zninjamonkey/3A-UPS-module/README.md

# 3A-UPS-module
made for hack club half life in 1 week. cut me some slack

This is supposed to be a UPS (uninterruptible power supply) module to power portable diy electronics projects.

It was inspired by the adafruit powerboost 1000c, but I wanted usb C connection and to be able to provide higher current to power devices such as a rapsberry pi.

It uses a BQ25306 for battery charging and load sharing, and a TPS61089 to boost the lithium ion battery to a 5V output. both chips are by Texas instruments. 

**kicad render**

<br>
**schematic**

<br>

I have not actually built this yet so I'm not sure if it even works
