zninjamonkey/3A-UPS-module/BOM.md

# Battery UPS board – bill of materials

<!-- Generated by Half Life from project cmuvqrdf302p601o9x2sgkxqi. Edits here are overwritten on the next sync. -->
<!-- Generated: 2026-10-13T04:54:23.885Z -->

> [!NOTE]
> This parts list is mirrored from [Half Life](https://halflife.hackclub.com). Editing it here will not change the platform's copy, and the next sync overwrites this file.

| Week | Tier | Parts funding |
| --- | --- | --- |
| Week 1 | Tier 1 | $30.00 |

| Part | What it's for | Qty | Unit | Total | Vendor |
| --- | --- | --- | --- | --- | --- |
| [TI BQ25306RTER](https://www.lcsc.com/product-detail/C3682611.html?s_z=s_p_BQ25306RTER) | battery charging and load sharing | 1 | $1.08 | $1.08 | [LCSC](https://www.lcsc.com/product-detail/C3682611.html?s_z=s_p_BQ25306RTER) |
| [TI TPS61089RNRR](https://www.lcsc.com/product-detail/C165129.html?s_z=n_q_TPS61089) | Battery Voltage Booster | 1 | $0.72 | $0.72 | [LCSC](https://www.lcsc.com/product-detail/C165129.html?s_z=n_q_TPS61089) |
| [AOS AO3401A](https://www.lcsc.com/product-detail/C15127.html?s_z=n_q_AO3401) | Load Sharing with BQ25306 | 1 | $0.51 | $0.51 | [LCSC](https://www.lcsc.com/product-detail/C15127.html?s_z=n_q_AO3401) |
| [USB4125-GF-A](https://www.lcsc.com/product-detail/C3151650.html?s_z=s_p_x_USB4125-GF-A) | charging the battery/powering the load | 1 | $1.05 | $1.05 | [LCSC](https://www.lcsc.com/product-detail/C3151650.html?s_z=s_p_x_USB4125-GF-A) |
| [XFCN PZ254R-11-02P](https://www.lcsc.com/product-detail/C492410.html?s_z=n_q_t_pin%2520header) | connecting an external battery and a load | 1 | $0.43 | $0.43 | [LCSC](https://www.lcsc.com/product-detail/C492410.html?s_z=n_q_t_pin%2520header) |
| [PCB](https://cart.jlcpcb.com/quote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) | connecting the components | 1 | $1.00 | $1.00 | [JLCPCB](https://cart.jlcpcb.com/quote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) |
| [Other passives](https://lcsc.com) | making it work | 1 | $6.39 | $6.39 | [LCSC](https://lcsc.com) |
| **Parts subtotal** | — | — | — | **$11.18** | — |
| **Tax & shipping** | — | — | — | **$21.35** | — |
| **Total** | — | — | — | **$32.53** | — |

**$2.53 over the tier's funding.** Every tier gives a fixed amount for parts, so this needs cutting back or a higher tier.
