zninjamonkey/3A-UPS-module/bom.csv

Id | Designator | Footprint | Quantity | Designation | Supplier and ref
1 | BT1 | PinHeader_1x02_P2.54mm_Horizontal | 1 | Battery_Cell
2 | C1 | C_1206_3216Metric | 1 | 10μF
3 | C2 | C_1206_3216Metric | 1 | 0.1μ
4 | C3, C4, C7, C8 | C_1206_3216Metric | 4 | 22μF
5 | C5 | C_1206_3216Metric | 1 | 120pF
6 | C6 | C_1206_3216Metric | 1 | 2.2nF
7 | C9, C10 | C_1206_3216Metric | 2 | 2.2µF
8 | C11 | C_1206_3216Metric | 1 | 470pF
9 | C12 | C_1206_3216Metric | 1 | 47 nF
10 | C13, C14 | C_1206_3216Metric | 2 | 10µF
11 | D2 | D_1206_3216Metric | 1 | D
12 | D4 | LED_1206_3216Metric | 1 | LED
13 | J1 | USB_C_Receptacle_GCT_USB4125-xx-x_6P_TopMnt_Horizontal | 1 | USB_C_Receptacle_PowerOnly_6P
14 | J3 | PinHeader_1x02_P2.54mm_Horizontal | 1 | Conn_01x02_Pin
15 | L1 | L_6.3x6.3_H3 | 1 | 2.2μH
16 | L2 | L_6.3x6.3_H3 | 1 | 1µH
17 | Q1 | SOT-23 | 1 | Q_PMOS_GDS
18 | R1, R2 | R_1206_3216Metric | 2 | 5.1k
19 | R3 | R_1206_3216Metric | 1 | 300k
20 | R4 | R_1206_3216Metric | 1 | 330k
21 | R5 | R_1206_3216Metric | 1 | 100k
22 | R6 | R_1206_3216Metric | 1 | 24k
23 | R7 | R_1206_3216Metric | 1 | 127k
24 | R8, R9, R12, R13, R16 | R_1206_3216Metric | 5 | 10k
25 | R10 | R_1206_3216Metric | 1 | 80k (0.5a)
26 | R11 | R_1206_3216Metric | 1 | 1k
27 | R14 | R_1206_3216Metric | 1 | 560k
28 | R15 | R_1206_3216Metric | 1 | 200k
29 | U1 | modified tps61089 | 1 | TPS61089
30 | U2 | IC_BQ25306RTER | 1 | BQ25306RTER
