zninjamonkey/3A-UPS-module/design files/board.kicad_pcb

## KiCad design design files/board.kicad_pcb (2026-10-13)

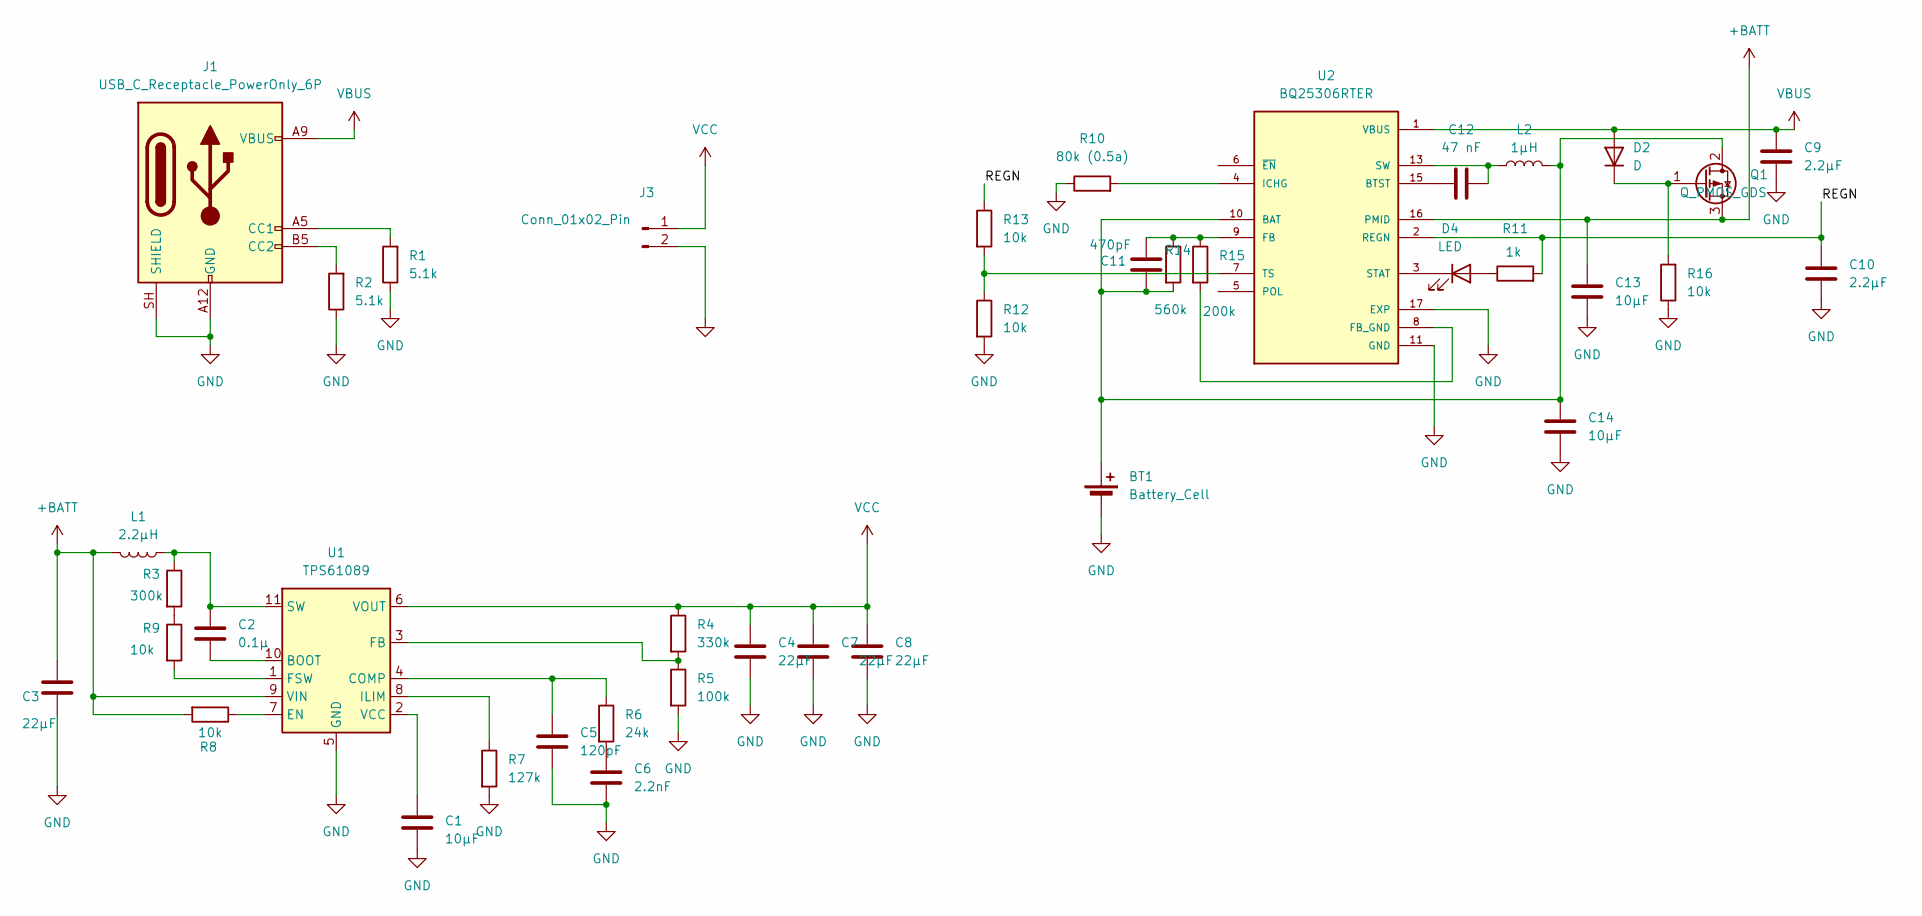
[picture p1: schematic board.kicad_sch]

Parts:
BT1: Battery_Cell; PinHeader_1x02_P2.54mm_Horizontal
C1: 10μF; C_1206_3216Metric
C2: 0.1μ; C_1206_3216Metric
C3, C4, C7, C8: 22μF; C_1206_3216Metric
C5: 120pF; C_1206_3216Metric
C6: 2.2nF; C_1206_3216Metric
C9, C10: 2.2µF; C_1206_3216Metric
C11: 470pF; C_1206_3216Metric
C12: 47 nF; C_1206_3216Metric
C13, C14: 10µF; C_1206_3216Metric
D2: D; D_SMA
D4: LED; LED_1206_3216Metric
J1: USB_C_Receptacle_PowerOnly_6P; USB_C_Receptacle_GCT_USB4125-xx-x_6P_TopMnt_Horizontal
J3: Conn_01x02_Pin; PinHeader_1x02_P2.54mm_Horizontal
L1: 2.2μH; L_6.3x6.3_H3
L2: 1µH; L_6.3x6.3_H3
Q1: Q_PMOS_GDS; SOT-23
R1, R2: 5.1k; R_1206_3216Metric
R3: 300k; R_1206_3216Metric
R4: 330k; R_1206_3216Metric
R5: 100k; R_1206_3216Metric
R6: 24k; R_1206_3216Metric
R7: 127k; R_1206_3216Metric
R8, R9, R12, R13, R16: 10k; R_1206_3216Metric
R10: 80k (0.5a); R_1206_3216Metric
R11: 1k; R_1206_3216Metric
R14: 560k; R_1206_3216Metric
R15: 200k; R_1206_3216Metric
U1: TPS61089; modified tps61089
U2: BQ25306RTER; IC_BQ25306RTER; PARTREV A

Connections:
+BATT: C3.1, C13.1, L1.2, Q1.3 (S), R8.2, U1.9 (VIN), U2.16 (PMID)
/REGN: C10.1, R11.2, R13.1, U2.2 (REGN)
GND: BT1.2 (-), C1.2, C3.2, C4.2, C5.2, C6.2, C7.2, C8.2, C9.2, C10.2, C13.2, C14.2, J1.A12 (GND), J1.B12 (GND), J1.SH (SHIELD), J3.2, R1.1, R2.1, R5.2, R7.2, R10.1, R12.2, R16.1, U1.5 (GND), U2.11 (GND), U2.12 (GND), U2.17 (EXP)
unnamed: BT1.1 (+), C11.1, C14.1, L2.2, Q1.2 (D), R14.2, U2.10 (BAT)
unnamed: C6.1, R6.2
unnamed: C12.2, L2.1, U2.13 (SW), U2.14 (SW)
unnamed: D2.1 (K), Q1.1 (G), R16.2
unnamed: D4.2 (A), R11.1
unnamed: D4.1 (K), U2.3 (STAT)
unnamed: J1.A5 (CC1), R1.2
unnamed: J1.B5 (CC2), R2.2
unnamed: R3.2, R9.1
unnamed: C2.2, U1.10 (BOOT)
unnamed: C5.1, R6.1, U1.4 (COMP)
unnamed: R8.1, U1.7 (EN)
unnamed: R4.2, R5.1, U1.3 (FB)
unnamed: R9.2, U1.1 (FSW)
unnamed: R7.1, U1.8 (ILIM)
unnamed: C2.1, L1.1, R3.1, U1.11 (SW)
unnamed: C1.1, U1.2 (VCC)
unnamed: C12.1, U2.15 (BTST)
unnamed: C11.2, R14.1, R15.1, U2.9 (FB)
unnamed: R15.2, U2.8 (FB_GND)
unnamed: R10.2, U2.4 (ICHG)
unnamed: R12.1, R13.2, U2.7 (TS)
VBUS: C9.1, D2.2 (A), J1.A9 (VBUS), J1.B9 (VBUS), U2.1 (VBUS)
VCC: C4.1, C7.1, C8.1, J3.1, R4.1, U1.6 (VOUT)

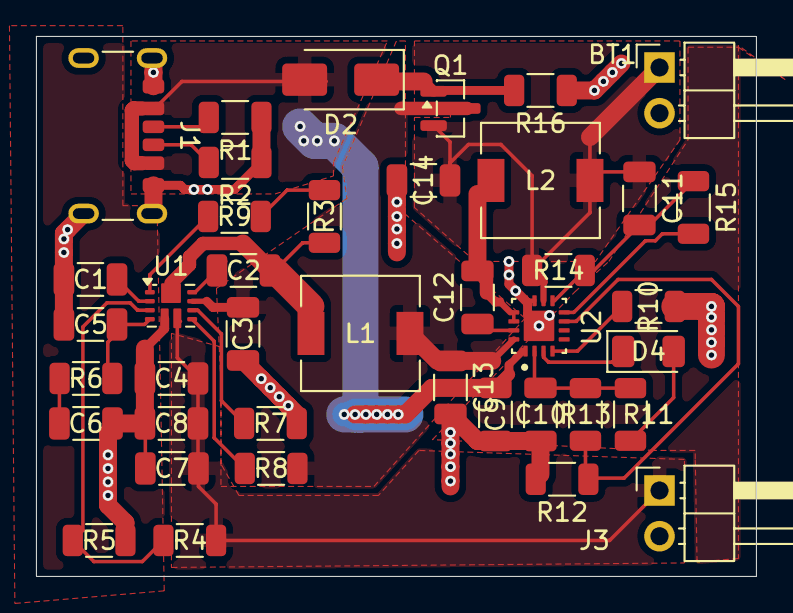
[picture p2: board board.kicad_pcb from above]

Board: 2 copper layers, 40.0 x 30.0 mm, 40 parts (0 on the bottom side), 27 nets.
