zninjamonkey/3A-UPS-module/(commit log)

2026-10-12 Sync Battery UPS board from Half Life
2026-10-12 add gerbers
2026-10-12 add kicad files
    [board.kicad_pcb, board.kicad_sch]
2026-10-12 add bom csv
    [bom.csv]
2026-10-13 updated gerbers
2026-10-13 updated design
    [board.kicad_pcb, board.kicad_sch]
